xenocoder/bigmuff/BMP-Triangle_Layout.pdf

EH BIG MUFF PI

Layout

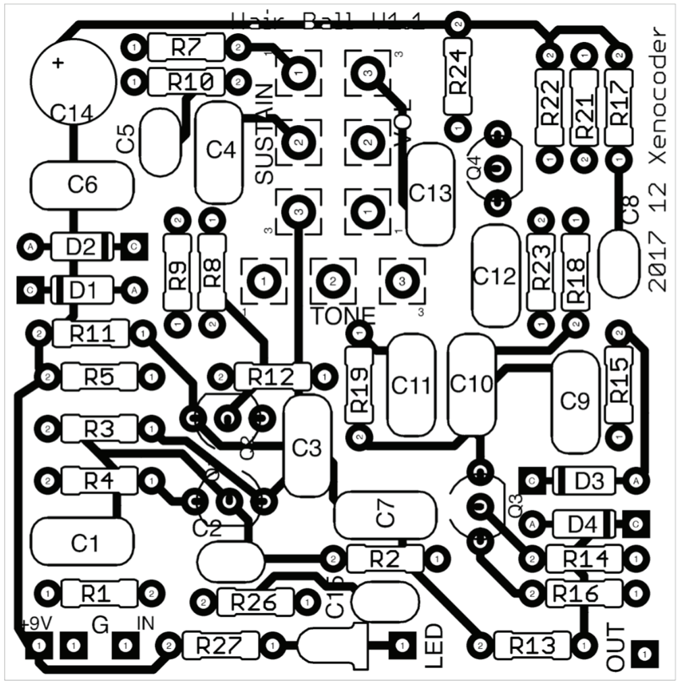
[picture p1: figure]
