xenocoder/bigmuff/bigmuffpipcb_wpotoutline.png

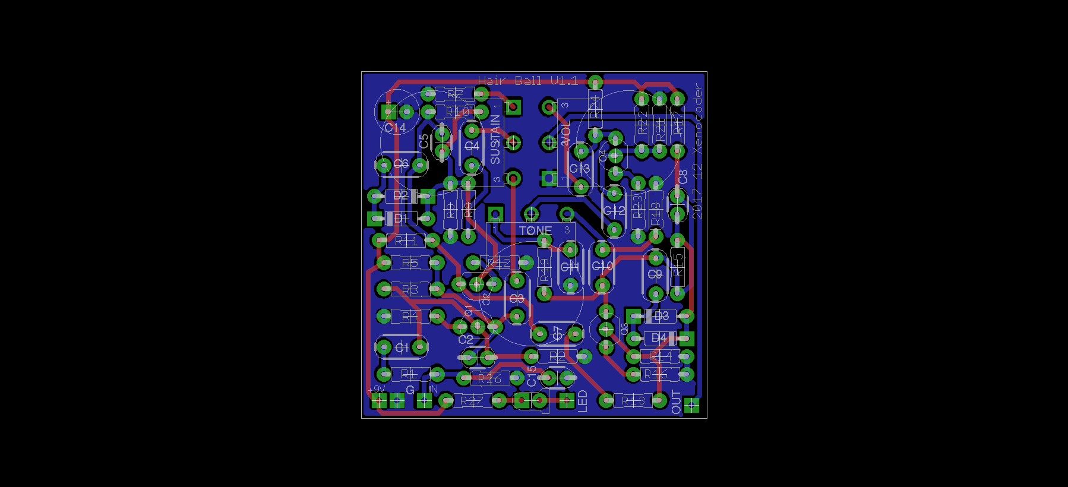
bigmuffpipcb_wpotoutline.png
