xenocoder/bigmuff/schematic.png

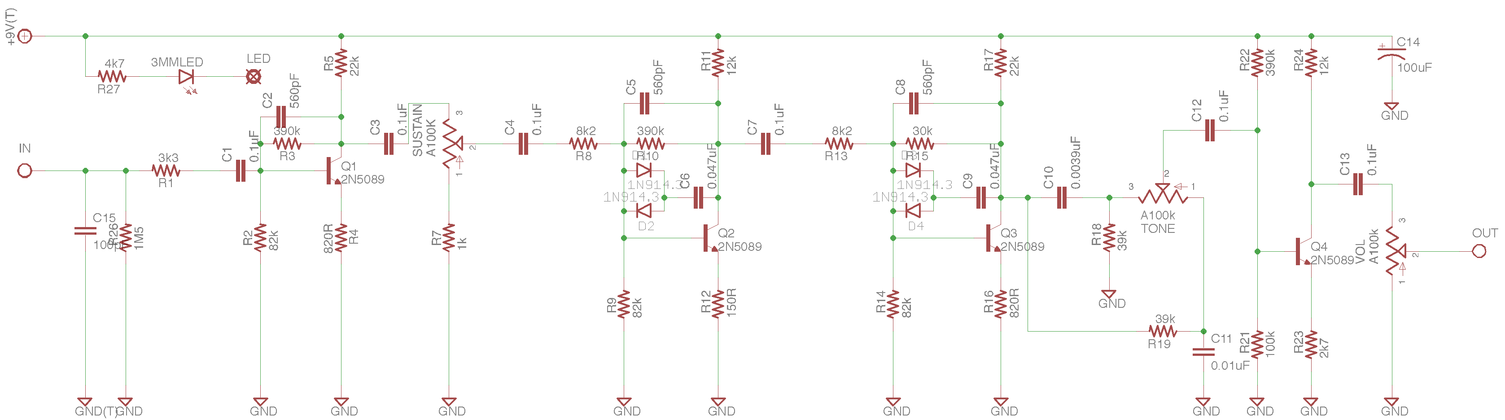
schematic.png
