xenocoder/bigmuff/BigMuffPi-Partlists_versions.pdf

Part # | Triangle | Ram's Head | Violet Ram's 1 | GGG Violet Rams 2 | Late 70s | Civil War | Green Russian | Black Russian
R1 | 3k3 | 39k | 33k | 39k | 39k | 39k | 39k | 39k
R2 | 82k | 47k | 100k | 100k | 100k | 100k | 100k | 100k
R3 | 390k | 470k | 470k | 470k | 470k | 470k | 470k | 470k
R4 | 820ohm | 120ohm | 100ohm | 100ohm | 100ohm | 390ohm | 390ohm | 390ohm
R5 | 22k | 10k | 12k | 15k | 15k | 12k | 12k | 12k
R6 | A100k | A100k | B100k | A100k | A100k | A100k | A100k | A100k
R7 | 1k | 1k | 560ohm | 1k | 1k | 1k | 1k | 1k
R8 | 8k2 | 10k | 8k2 | 8k2 | 8k2 | 10k | 10k | 10k
R9 | 82k | 100k | 100k | 100k | 100k | 100k | 100k | 100k
R10 | 390k | 470k | 470k | 470k | 470k | 470k | 470k | 470k
R11 | 12k | 10k | 12k | 10k | 15k | 12k | 12k | 12k
R12 | 150ohm | 150ohm | 100ohm | 100ohm | 100ohm | 390ohm | 390ohm | 390ohm
R13 | 8k2 | 10k | 8k2 | 8k2 | 8k2 | 10k | 10k | 10k
R14 | 82k | 100k | 100k | 100k | 100k | 100k | 100k | 100k
R15 | 390k | 470k | 470k | 470k | 470k | 470k | 470k | 470k
R16 | 820ohm | 150ohm | 100ohm | 100ohm | 100ohm | 390ohm | 390ohm | 390ohm
R17 | 22k | 15k | 12k | 15k | 15k | 12k | 12k | 12k
R18 | 39k | 22k | 33k | 39k | 100k | 22k | 22k | 22k
R19 | 39k | 39k | 33k | 39k | 39k | 20k | 20k | 22k
R20 | B100K | B100K | B100k | B100K | B100K | B100K | B100K | B100K
R21 | 100k | 100k | 100k | 100k | 100k | 100k | 100k | 100k
R22 | 390k | 430k | 470k | 390k | 390k | 470k | 470k | 470k
R23 | 2k7 | 3k3 | 2k7 | 2k7 | 2k2 | 2k7 | 2k | 2k7
R24 | 12k | 15k | 12k | 10k | 10k | 10k | 10k | 10k
R25 | A100k | A100k | B100k | A100k | A100k | A100k | A100k | A100k
R26 | 1M5 | 1M5 | 1M5 | 1M5 | 1M5 | 1M5 | 1M5 | 1M5
R27 | 1k | 1k | 1k | 1k | 1k | 1k | 1k | 1k
C1 | 100nF film | 10uF Elec | 100nF film | 100nF film | 100nF film | 100nF film | 100nF film | 100nF film
C2 | 560pF Cer | 560pF Cer | 560pF Cer | 470pF Cer | 500pF Cer | 430pF Cer | 470pF Cer | 470pF Cer
C3 | 100nF film | 100nF film | 100nF film | 100nF film | 1 uF Film | 100nF film | 100nF film | 100nF film
C4 | 100nF film | 100nF film | 100nF film | 100nF film | 1 uF Film | 100nF film | 100nF film | 100nF film
C5 | 560pF Cer | 560pF Cer | 560pF Cer | 470pF Cer | 500pF Cer | 430pF Cer | 470pF Cer | 470pF Cer
C6 | 47nF film | 100nF film | 100nF film | 100nF film | 100nF film | 47nF film | 47nF film | 47nF film
C7 | 100nF film | 100nF film | 100nF film | 100nF film | 1 uF Film | 100nF film | 100nF film | 100nF film
C8 | 560pF Cer | 560pF Cer | 560pF Cer | 470pF Cer | 500pF Cer | 430pF Cer | 470pF Cer | 470pF Cer
C9 | 47nF film | 1uF Film/Elc100nF film | | 100nF film | 100nF film | 47nF film | 47nF film | 47nF film
C10 | 3.9nF Film | 3.9nF Film | 3.9nF Film | 3.9nF Film | 3.9nF Film | 3.9nF Film | 3.9nF Film | 3.9nF Film
C11 | 10nF Film | 10nF Film | 10nF Film | 10nF Film | 10nF Film | 10nF Film | 10nF Film | 10nF Film
C12 | 100nF film | 100nF film | 100nF film | 100nF film | 100nF film | 100nF film | 100nF film | 100nF film

Big Muff Pi Versions

C13 | 100nF film | 1uF Film/Elc100nF film | | 100nF film | 100nF film | 100nF film | 100nF film | 100nF film
C14 | 100uF Elec | 100uF Elec | 100uF Elec | 100uF Elec | 100uF Elec | 100uF Elec | 100uF Elec | 100uF Elec
C15 | 100pF cer | 100pF cer | 100pF cer | 100pF cer | 100pF cer | 100pF cer | 100pF cer | 100pF cer
D1 | 1N914 | 1N914 | 1N914 | 1N914 | 1N914 | 1N914 | 1N914 | 1N914
D2 | 1N914 | 1N914 | 1N914 | 1N914 | 1N914 | 1N914 | 1N914 | 1N914
D3 | 1N914 | 1N914 | 1N914 | 1N914 | 1N914 | 1N914 | 1N914 | 1N914
D4 | 1N914 | 1N914 | 1N914 | 1N914 | 1N914 | 1N914 | 1N914 | 1N914
D5 | LED | LED | LED | LED | LED | LED | LED | LED
Q1 | 2N5088 | 2N5088 | 2N5088 | 2N5088 | 2N5088 | 2N5089 | 2N5088 | 2N5088
Q2 | 2N5088 | 2N5088 | 2N5088 | 2N5088 | 2N5088 | 2N5089 | 2N5088 | 2N5088
Q3 | 2N5088 | 2N5088 | 2N5088 | 2N5088 | 2N5088 | 2N5089 | 2N5088 | 2N5088
Q4 | 2N5088 | 2N5088 | 2N5088 | 2N5088 | 2N5088 | 2N5089 | 2N5088 | 2N5088
