xenocoder/bigmuff/BigMuffPi-Partlists_versions.xlsx

Big Muff Pi Versions
Part # | Triangle | Ram's Head | Violet Ram's 1 | GGG Violet Rams 2 | Late 70s | Civil War | Green Russian | Black Russian | Xenocoder Default | Xeno Part #
R1 | 3k3 | 39k | 33k | 39k | 39k | 39k | 39k | 39k | 3k3 | R1
R2 | 82k | 47k | 100k | 100k | 100k | 100k | 100k | 100k | 82k | R2
R3 | 390k | 470k | 470k | 470k | 470k | 470k | 470k | 470k | 390k | R3
R4 | 820ohm | 120ohm | 100ohm | 100ohm | 100ohm | 390ohm | 390ohm | 390ohm | 820R | R4
R5 | 22k | 10k | 12k | 15k | 15k | 12k | 12k | 12k | 22k | R5
R6 | A100k | A100k | B100k | A100k | A100k | A100k | A100k | A100k | A100K | R6
R7 | 1k | 1k | 560ohm | 1k | 1k | 1k | 1k | 1k | 1k | R7
R8 | 8k2 | 10k | 8k2 | 8k2 | 8k2 | 10k | 10k | 10k | 8k2 | R8
R9 | 82k | 100k | 100k | 100k | 100k | 100k | 100k | 100k | 82k | R9
R10 | 390k | 470k | 470k | 470k | 470k | 470k | 470k | 470k | 390k | R10
R11 | 12k | 10k | 12k | 10k | 15k | 12k | 12k | 12k | 12k | R11
R12 | 150ohm | 150ohm | 100ohm | 100ohm | 100ohm | 390ohm | 390ohm | 390ohm | 150R | R12
R13 | 8k2 | 10k | 8k2 | 8k2 | 8k2 | 10k | 10k | 10k | 8k2 | R13
R14 | 82k | 100k | 100k | 100k | 100k | 100k | 100k | 100k | 82k | R14
R15 | 390k | 470k | 470k | 470k | 470k | 470k | 470k | 470k | 390k | R15
R16 | 820ohm | 150ohm | 100ohm | 100ohm | 100ohm | 390ohm | 390ohm | 390ohm | 820R | R16
R17 | 22k | 15k | 12k | 15k | 15k | 12k | 12k | 12k | 22k | R17
R18 | 39k | 22k | 33k | 39k | 100k | 22k | 22k | 22k | 39k | R18
R19 | 39k | 39k | 33k | 39k | 39k | 20k | 20k | 22k | 39k | R19
R20 | B100K | B100K | B100k | B100K | B100K | B100K | B100K | B100K | B100k | R20
R21 | 100k | 100k | 100k | 100k | 100k | 100k | 100k | 100k | 100k | R21
R22 | 390k | 430k | 470k | 390k | 390k | 470k | 470k | 470k | 390k | R22
R23 | 2k7 | 3k3 | 2k7 | 2k7 | 2k2 | 2k7 | 2k | 2k7 | 2k7 | R23
R24 | 12k | 15k | 12k | 10k | 10k | 10k | 10k | 10k | 12k | R24
R25 | A100k | A100k | B100k | A100k | A100k | A100k | A100k | A100k | A100k | R25
R26 | 1M5 | 1M5 | 1M5 | 1M5 | 1M5 | 1M5 | 1M5 | 1M5 | 1M5 | R26
R27 | 1k | 1k | 1k | 1k | 1k | 1k | 1k | 1k | 4k7 | R27
C1 | 100nF film | 10uF Elec | 100nF film | 100nF film | 100nF film | 100nF film | 100nF film | 100nF film | 0.1uF | C1
C2 | 560pF Cer | 560pF Cer | 560pF Cer | 470pF Cer | 500pF Cer | 430pF Cer | 470pF Cer | 470pF Cer | 560pF | C2
C3 | 100nF film | 100nF film | 100nF film | 100nF film | 1 uF Film | 100nF film | 100nF film | 100nF film | 0.1uF | C3
C4 | 100nF film | 100nF film | 100nF film | 100nF film | 1 uF Film | 100nF film | 100nF film | 100nF film | 0.1uF | C4
C5 | 560pF Cer | 560pF Cer | 560pF Cer | 470pF Cer | 500pF Cer | 430pF Cer | 470pF Cer | 470pF Cer | 560pF | C5
C6 | 47nF film | 100nF film | 100nF film | 100nF film | 100nF film | 47nF film | 47nF film | 47nF film | 0.047uF | C6
C7 | 100nF film | 100nF film | 100nF film | 100nF film | 1 uF Film | 100nF film | 100nF film | 100nF film | 0.1uF | C7
C8 | 560pF Cer | 560pF Cer | 560pF Cer | 470pF Cer | 500pF Cer | 430pF Cer | 470pF Cer | 470pF Cer | 560pF | C8
C9 | 47nF film | 1uF Film/Elc | 100nF film | 100nF film | 100nF film | 47nF film | 47nF film | 47nF film | 0.047uF | C9
C10 | 3.9nF Film | 3.9nF Film | 3.9nF Film | 3.9nF Film | 3.9nF Film | 3.9nF Film | 3.9nF Film | 3.9nF Film | 0.0039uF | C10
C11 | 10nF Film | 10nF Film | 10nF Film | 10nF Film | 10nF Film | 10nF Film | 10nF Film | 10nF Film | 0.01uF | C11
C12 | 100nF film | 100nF film | 100nF film | 100nF film | 100nF film | 100nF film | 100nF film | 100nF film | 0.1uF | C12
C13 | 100nF film | 1uF Film/Elc | 100nF film | 100nF film | 100nF film | 100nF film | 100nF film | 100nF film | 0.1uF | C13
C14 | 100uF Elec | 100uF Elec | 100uF Elec | 100uF Elec | 100uF Elec | 100uF Elec | 100uF Elec | 100uF Elec | 100uF | C14
C15 | 100pF cer | 100pF cer | 100pF cer | 100pF cer | 100pF cer | 100pF cer | 100pF cer | 100pF cer | 100pF | C15
D1 | 1N914 | 1N914 | 1N914 | 1N914 | 1N914 | 1N914 | 1N914 | 1N914 | 1N914.3 | D1
D2 | 1N914 | 1N914 | 1N914 | 1N914 | 1N914 | 1N914 | 1N914 | 1N914 | 1N914.3 | D2
D3 | 1N914 | 1N914 | 1N914 | 1N914 | 1N914 | 1N914 | 1N914 | 1N914 | 1N914.3 | D3
D4 | 1N914 | 1N914 | 1N914 | 1N914 | 1N914 | 1N914 | 1N914 | 1N914 | 1N914.3 | D4
D5 | LED | LED | LED | LED | LED | LED | LED | LED | LED
Q1 | 2N5088 | 2N5088 | 2N5088 | 2N5088 | 2N5088 | 2N5089 | 2N5088 | 2N5088 | 2N5089 | Q1
Q2 | 2N5088 | 2N5088 | 2N5088 | 2N5088 | 2N5088 | 2N5089 | 2N5088 | 2N5088 | 2N5089 | Q2
Q3 | 2N5088 | 2N5088 | 2N5088 | 2N5088 | 2N5088 | 2N5089 | 2N5088 | 2N5088 | 2N5089 | Q3
Q4 | 2N5088 | 2N5088 | 2N5088 | 2N5088 | 2N5088 | 2N5089 | 2N5088 | 2N5088 | 2N5089 | Q4
