xenocoder/bigmuff/BMP-1590B-DrillGuide.pdf

Big Muff | Big Muff

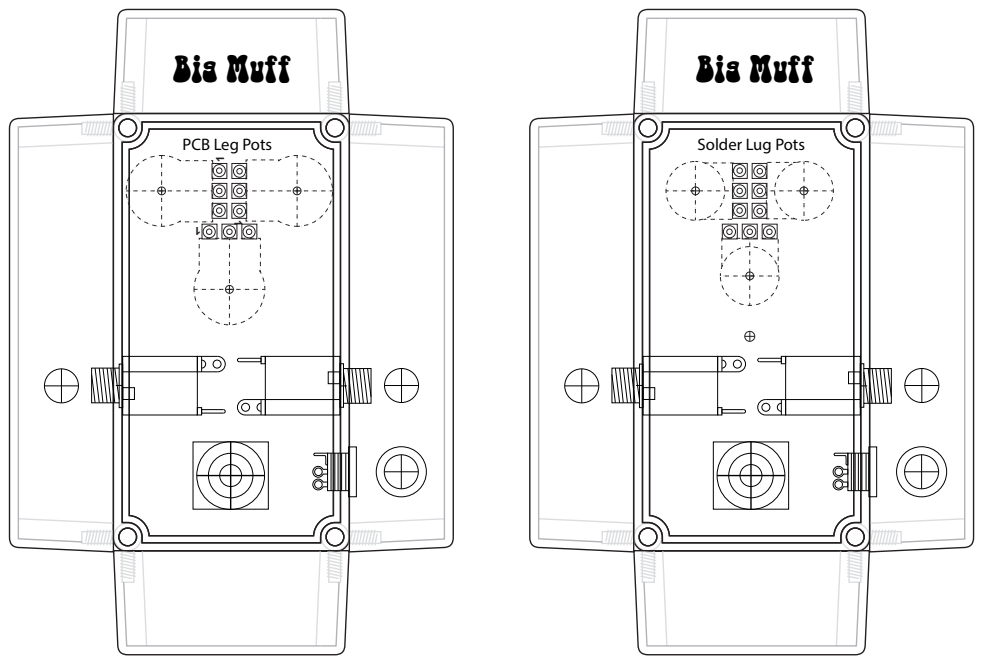
[picture p4: page 1]
PCB Leg Pots; Solder Lug Pots
