xenocoder/bigmuff/BMP-Triangle_Schematic.pdf

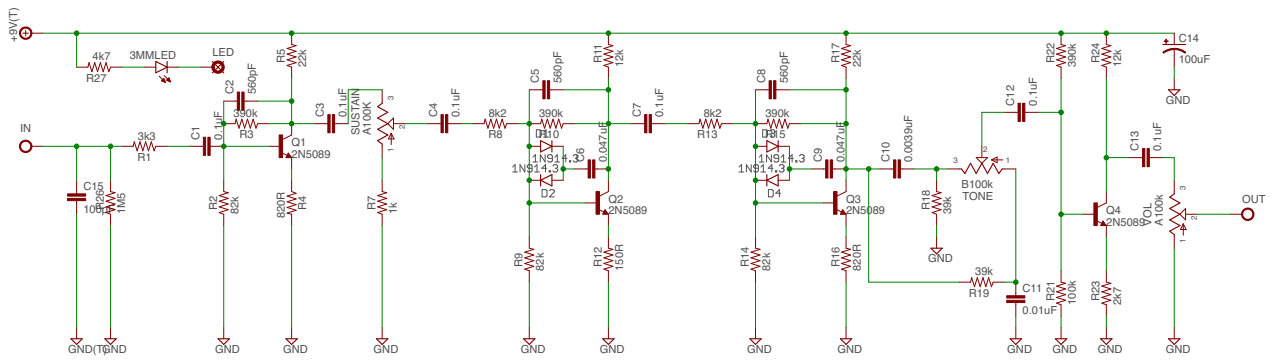
[picture p5: page 1]
