xenocoder/bigmuff/BMP-Triangle.sch

## EAGLE design BMP-Triangle.sch (2018-01-27)

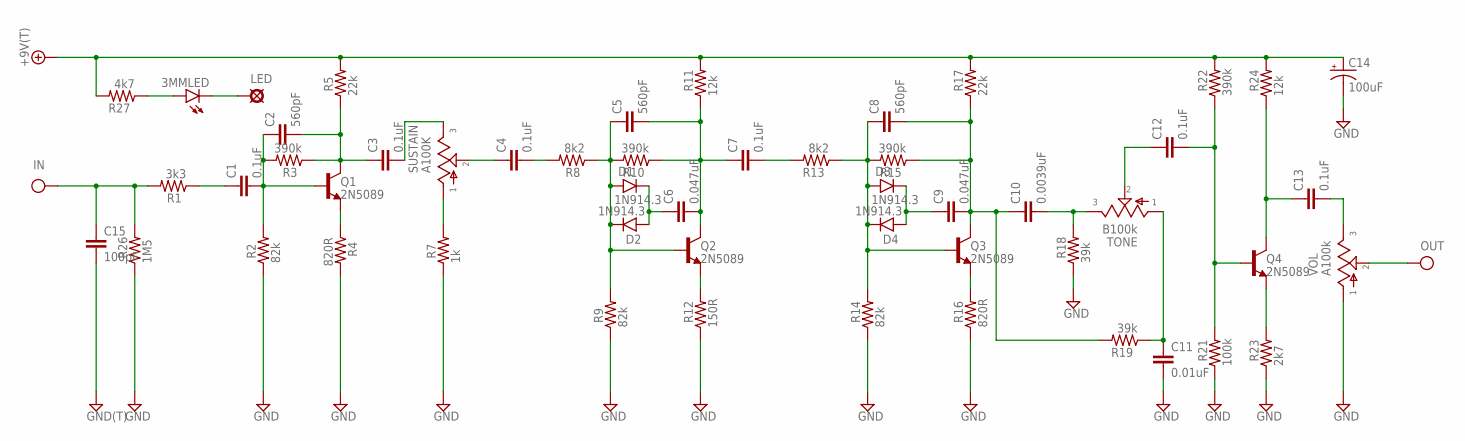
[picture p6: schematic BMP-Triangle.sch]

Parts:
3MMLED: LED3MM
+9V: +9V(T); SQUARE
C1, C3, C4, C7, C12, C13: 0.1uF; 075X035
C2, C5, C8: 560pF; 050X030_050_1
C6, C9: 0.047uF; 075X035
C10: 0.0039uF; 075X035
C11: 0.01uF; 075X035
C14: 100uF; 063_025
C15: 100pF; 050X030_050_1
D1, D2, D3, D4: 1N914.3; DO35-3
G: GND(T); SQUARE
IN: IN(T); SQUARE
LED: PAD; SQUARE
OUT: OUT(T); SQUARE
Q1, Q2, Q3, Q4: 2N5089; TO92-
R1: 3k3; R0207/3
R2, R9, R14: 82k; R0207/3
R3, R10, R15, R22: 390k; R0207/3
R4, R16: 820R; R0207/3
R5, R17: 22k; R0207/3
R7: 1k; R0207/3
R8, R13: 8k2; R0207/3
R11, R24: 12k; R0207/3
R12: 150R; R0207/3
R18, R19: 39k; R0207/3
R21: 100k; R0207/3
R23: 2k7; R0207/3
R26: 1M5; R0207/3
R27: 4k7; R0207/3
SUSTAIN: A100K; 16MM_PCB_PADS
TONE: B100k; 16MM_PCB_PADS
VOL: A100k; 16MM_PCB_PADS

Connections:
+9V: +9V.1, C14.+, R5.2, R11.2, R17.2, R22.2, R24.2, R27.2
GND: C11.2, C14.-, C15.2, G.1, R2.1, R4.2, R7.1, R9.1, R12.1, R14.1, R16.1, R18.1, R21.1, R23.1, R26.1, VOL.1
IN: C15.1, IN.1, R1.2, R26.2
unnamed: C4.1, SUSTAIN.2
unnamed: C1.1, R1.1
unnamed: C1.2, C2.1, Q1.2 (B), R2.2, R3.2
unnamed: C2.2, C3.1, Q1.1 (C), R3.1, R5.1
unnamed: Q1.3 (E), R4.1
unnamed: C3.2, SUSTAIN.3
unnamed: R7.2, SUSTAIN.1
unnamed: C4.2, R8.2
unnamed: C5.1, D1.A, D2.C, Q2.2 (B), R8.1, R9.2, R10.2
unnamed: C6.1, D1.C, D2.A
unnamed: C5.2, C6.2, C7.1, Q2.1 (C), R10.1, R11.1
unnamed: Q2.3 (E), R12.2
unnamed: C7.2, R13.2
unnamed: C8.1, D3.A, D4.C, Q3.2 (B), R13.1, R14.2, R15.2
unnamed: Q3.3 (E), R16.2
unnamed: C8.2, C9.2, C10.1, Q3.1 (C), R15.1, R17.1, R19.2
unnamed: C9.1, D3.C, D4.A
unnamed: C10.2, R18.2, TONE.3
unnamed: C11.1, R19.1, TONE.1
unnamed: C12.1, TONE.2
unnamed: C12.2, Q4.2 (B), R21.2, R22.1
unnamed: C13.1, Q4.1 (C), R24.1
unnamed: Q4.3 (E), R23.2
unnamed: C13.2, VOL.3
unnamed: 3MMLED.A, R27.1
unnamed: 3MMLED.K (C), LED.1
OUT: OUT.1, VOL.2
