xenocoder/bigmuff/1590B_DrillGuide.pdf

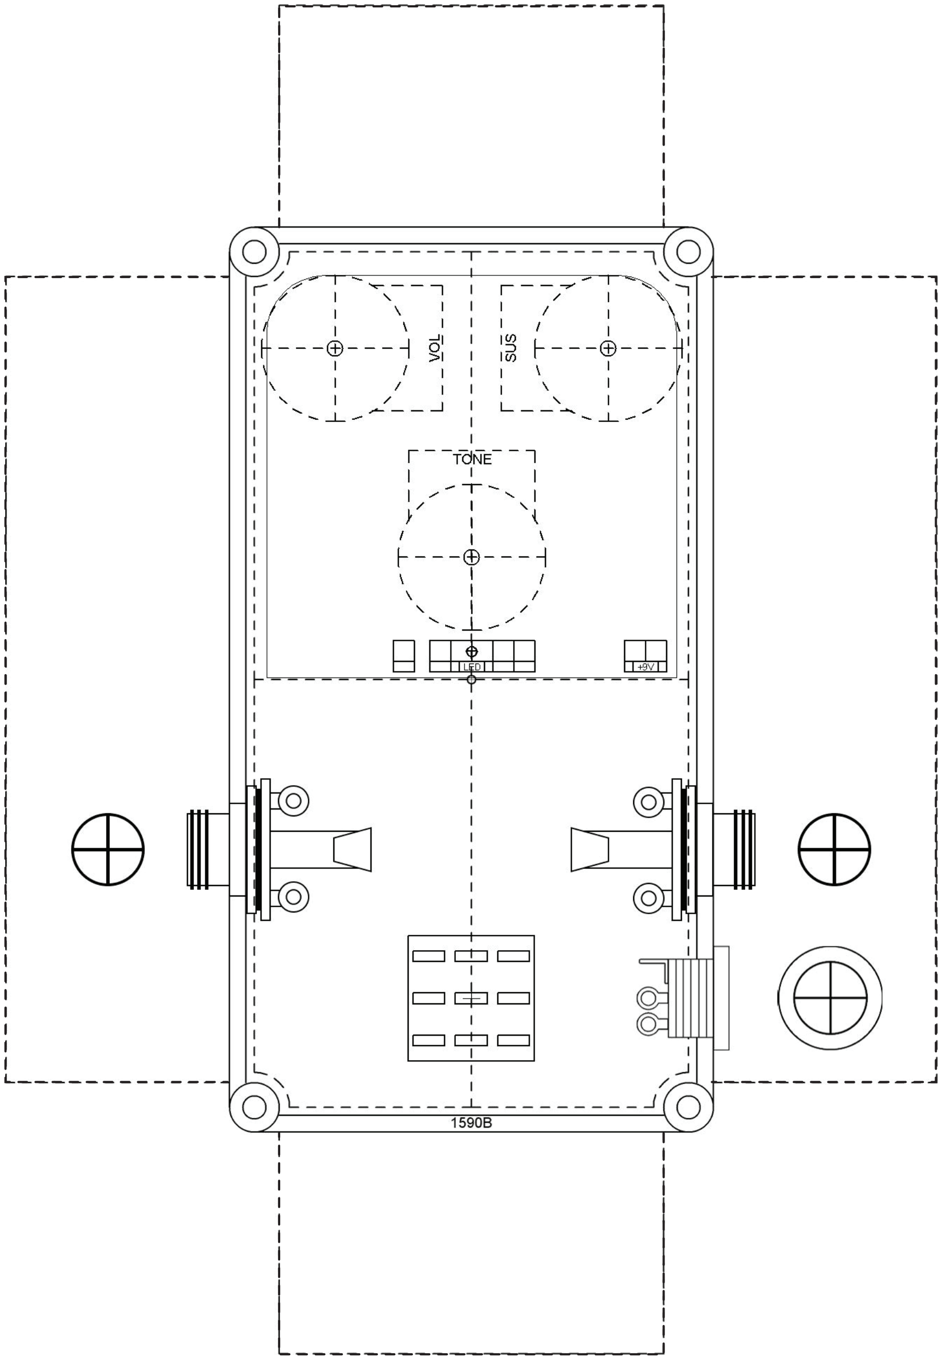
[picture p9: figure]
