xenocoder/bigmuff/(commit log)

2016-01-02 Version 1.0 first layout
    [BMP-Triangle.brd, BMP-Triangle.sch]
2017-12-29 Fixed R15 value and updated board annotation
    [BigMuffPi-Partlists_versions.xlsx]
2017-12-30 Ran CAM job to get Gerber files for Seeed order
    [BMP-Triangle.GBL, BMP-Triangle.GBO, BMP-Triangle.GBP, BMP-Triangle.GBS, BMP-Triangle.GTL, BMP-Triangle.GTO, BMP-Triangle.GTP, BMP-Triangle.GTS]
2018-01-11 Added new drill guide and partslist
    [BigMuffPi-Partlists_versions.xlsx]
2018-01-13 Cleaned up directory to release V1.1. These are files send to Seeed and docs to help build out boards.
    [BMP-Triangle.GBL, BMP-Triangle.GBO, BMP-Triangle.GBP, BMP-Triangle.GBS, BMP-Triangle.GTL, BMP-Triangle.GTO, BMP-Triangle.GTP, BMP-Triangle.GTS]
2018-01-13 Removed extra drill guide file
2018-01-13 Added dev files back in
    [BMP-Triangle.GBL, BMP-Triangle.GBO, BMP-Triangle.GBP, BMP-Triangle.GBS, BMP-Triangle.GTL, BMP-Triangle.GTO, BMP-Triangle.GTP, BMP-Triangle.GTS]
2018-01-27 Added build guide and updated files
    [BMP-Triangle.sch]
2020-01-17 Add Drill Guide
